LouisPauchet/open-permafrost-monitor/cao/AntennaSupport/AntennaSupport.3mf

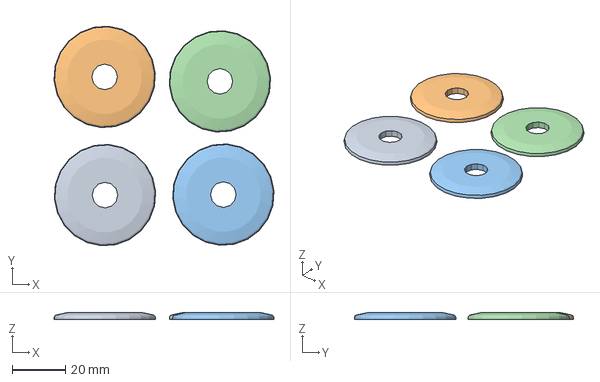
[picture p1: CAD file, 2026-07-15]
cao/AntennaSupport/AntennaSupport.3mf
82.3 x 82.1 x 2.60 mm
AntennaSupport.stl x 4
