LouisPauchet/open-permafrost-monitor/cao/RaspberryShake/GPSBoardMountA&B.3mf

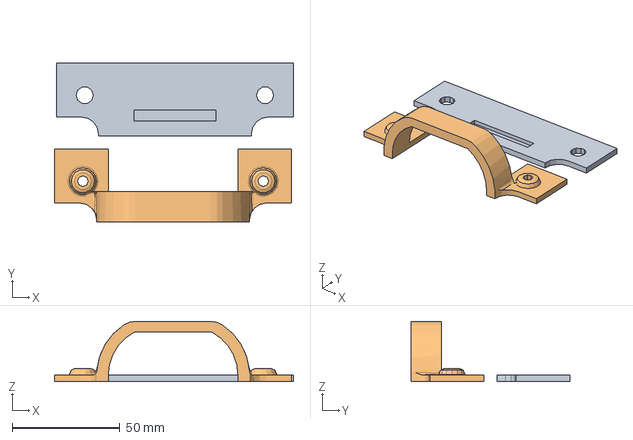
[picture p2: CAD file, 2026-08-08]
cao/RaspberryShake/GPSBoardMountA&B.3mf
111.0 x 73.7 x 28.0 mm
GPSBoardMountA.stl
GPSBoardMountB.stl
