LouisPauchet/open-permafrost-monitor/cao/AntennaSupport/AntennaSupport_v2.3mf

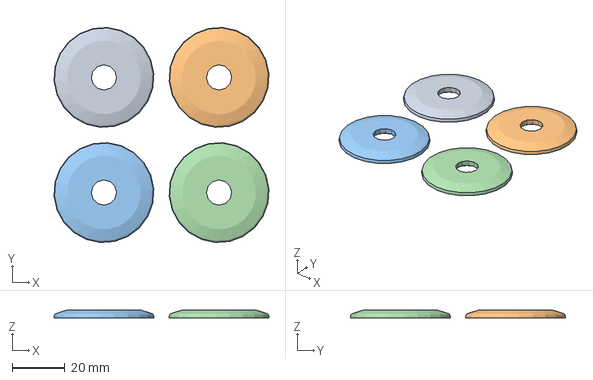
[picture p3: CAD file, 2026-07-15]
cao/AntennaSupport/AntennaSupport_v2.3mf
81.6 x 81.6 x 3.10 mm
AntennaSupport_v2.stl x 4
