LouisPauchet/open-permafrost-monitor/cao/RaspberryShake/GeophonesHolder.stl

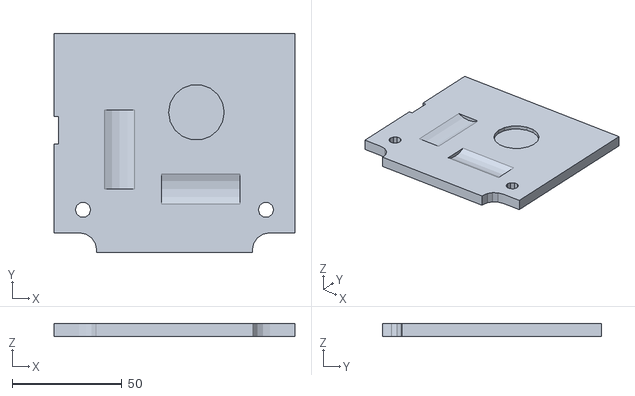
[picture p4: CAD file, 2026-08-08]
cao/RaspberryShake/GeophonesHolder.stl
110.0 x 100.0 x 6.00
