LouisPauchet/open-permafrost-monitor/cao/RaspberryShake/GPSBoardMountA.stl

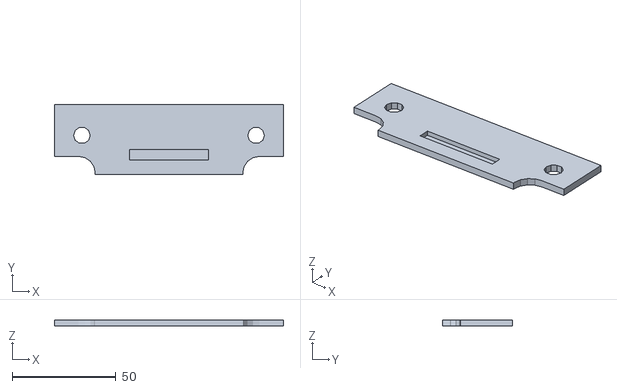
[picture p5: CAD file, 2026-08-08]
cao/RaspberryShake/GPSBoardMountA.stl
110.2 x 33.8 x 3.00
