LouisPauchet/open-permafrost-monitor/cao/RaspberryShake/GPSBoardMountB.stl

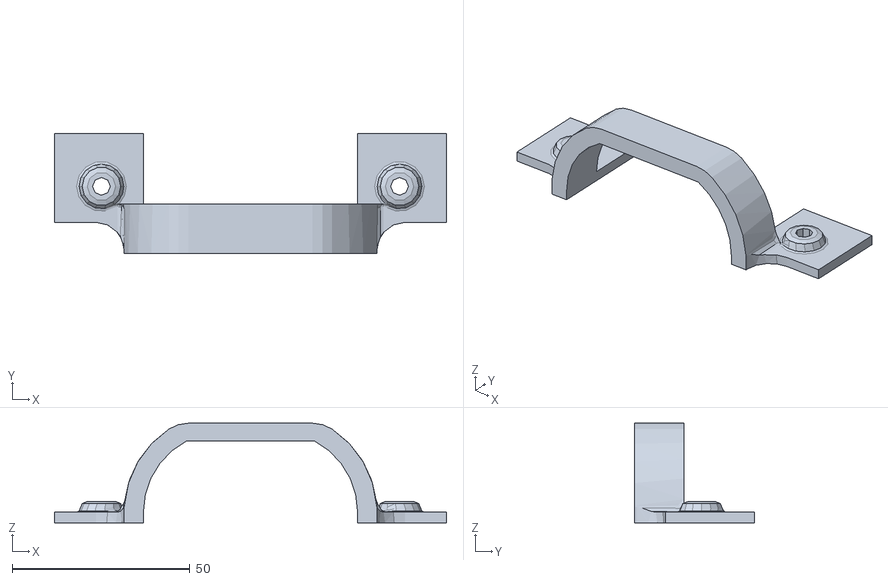
[picture p6: CAD file, 2026-08-08]
cao/RaspberryShake/GPSBoardMountB.stl
110.2 x 33.8 x 28.0
