LouisPauchet/open-permafrost-monitor/cao/RaspberryShake/GeophonesHolder_v3.4.3mf

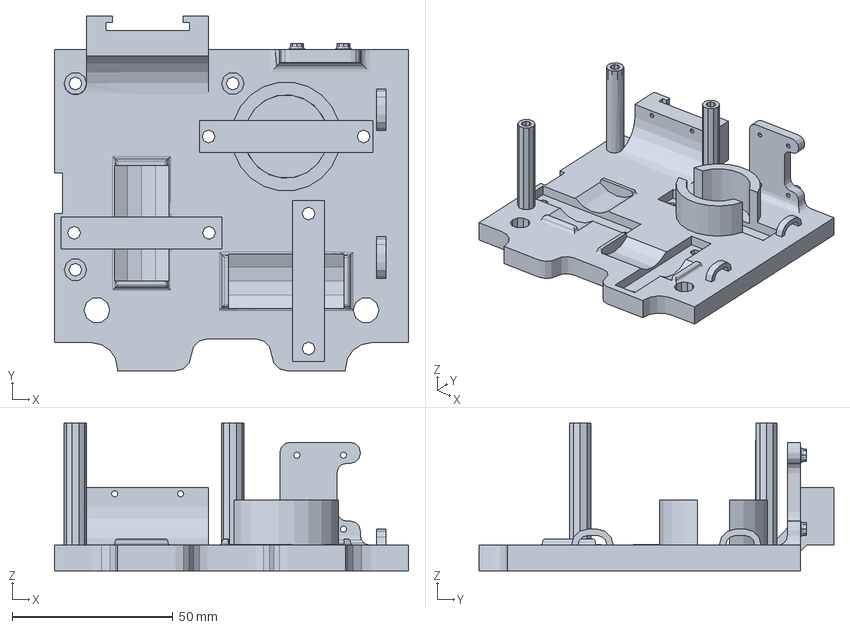
[picture p7: CAD file, 2026-08-08]
cao/RaspberryShake/GeophonesHolder_v3.4.3mf
110.2 x 110.5 x 46.0 mm
