LouisPauchet/open-permafrost-monitor/cao/RaspberryShake/GeophonesHolder_v3.3.3mf

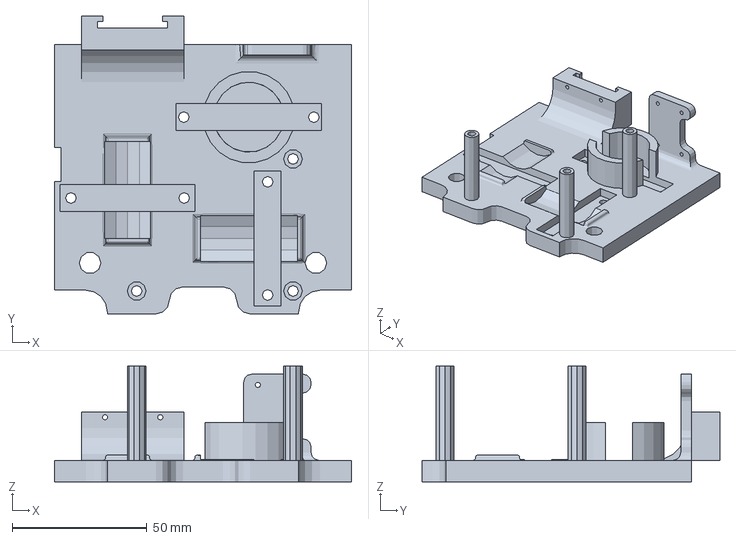
[picture p8: CAD file, 2026-08-08, an earlier design]
cao/RaspberryShake/GeophonesHolder_v3.3.3mf
110.2 x 110.5 x 43.0 mm
