LouisPauchet/open-permafrost-monitor/cao/RaspberryShake/GeophonesHolder_v3.1.3mf

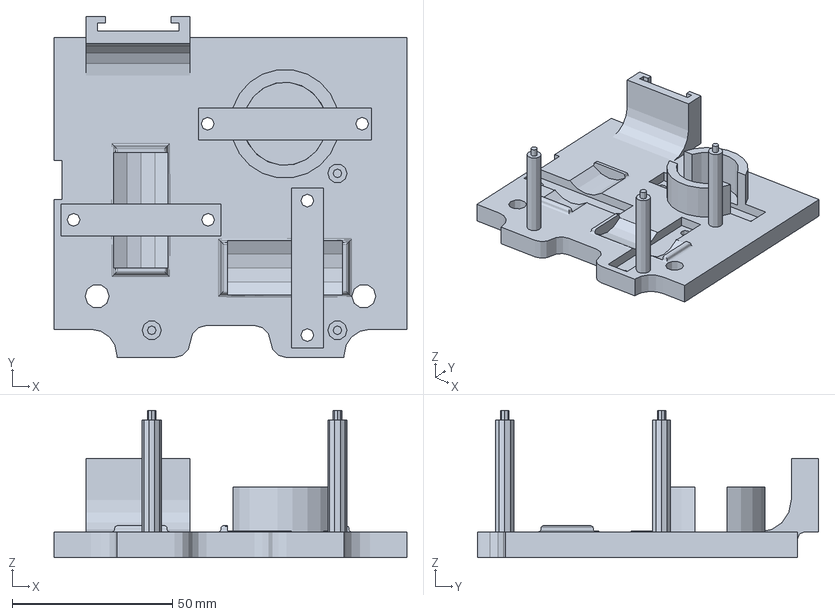
[picture p9: CAD file, 2026-08-08, an earlier design]
cao/RaspberryShake/GeophonesHolder_v3.1.3mf
110.2 x 106.5 x 46.0 mm
