LouisPauchet/open-permafrost-monitor/cao/RaspberryShake/GeophonesHolder_v3.3mf

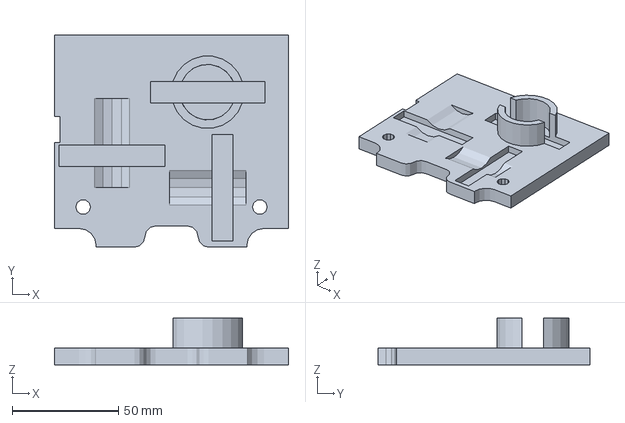
[picture p10: CAD file, 2026-08-08, an earlier design]
cao/RaspberryShake/GeophonesHolder_v3.3mf
110.2 x 100.0 x 22.0 mm
