LouisPauchet/open-permafrost-monitor/cao/RaspberryShake/GeophonesHolder_v2.3mf

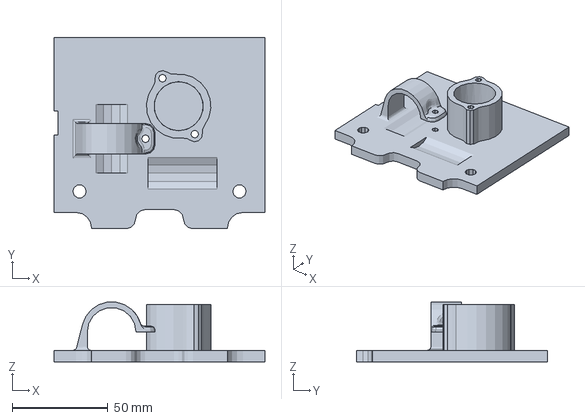
[picture p11: CAD file, 2026-08-08, an earlier design]
cao/RaspberryShake/GeophonesHolder_v2.3mf
110.2 x 100.0 x 31.2 mm
