LouisPauchet/open-permafrost-monitor/cao/RaspberryShake/GeophonesHolder_v3.2.3mf

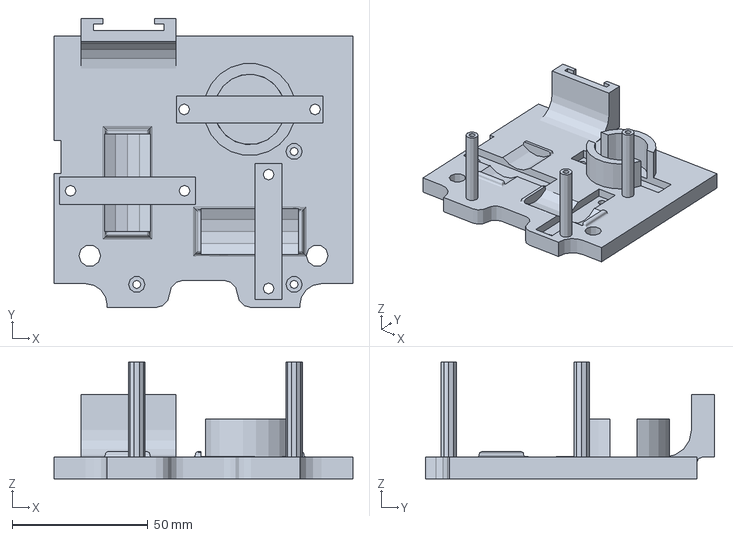
[picture p12: CAD file, 2026-08-08, an earlier design]
cao/RaspberryShake/GeophonesHolder_v3.2.3mf
110.2 x 106.5 x 43.0 mm
