LouisPauchet/open-permafrost-monitor/(list of files, cad)

Other CAD files:
cao/RaspberryShake/GeophonesHolder_v&.3mf
cao/RaspberryShake/GeophonesHolder_v1.3mf
cao/AntennaSupport/AntennaSupport.CATPart
cao/AntennaSupport/AntennaSupport.stl
cao/AntennaSupport/AntennaSupport_v2.stl
cao/RaspberryShake/Box_bottom.CATPart
cao/RaspberryShake/GPSBoardMountA.CATPart
cao/RaspberryShake/GPSBoardMountB.CATPart
cao/RaspberryShake/Geophones.CATPart
cao/RaspberryShake/GeophonesHolder.CATPart
cao/RaspberryShake/GeophonesHolder_v2.stl
cao/RaspberryShake/GeophonesHolder_v3.1.stl
cao/RaspberryShake/GeophonesHolder_v3.2.stl
cao/RaspberryShake/GeophonesHolder_v3.3.stl
cao/RaspberryShake/GeophonesHolder_v3.4.stl
cao/RaspberryShake/GeophonesHolder_v3.CATPart
cao/RaspberryShake/GeophonesHolder_v3.stl
cao/RaspberryShake/RaspberryShake.CATProduct
