LouisPauchet/open-permafrost-monitor/src/sd_storage.cpp

#include "sd_storage.h"
#include "pins.h"
#include <SD.h>
#include <SPI.h>
#include <USBMSC.h>
#include <freertos/FreeRTOS.h>
#include <freertos/semphr.h>
#include <freertos/task.h>
#include <string.h>

// Switched from native SDMMC to SD-over-SPI: repeated real-hardware failures
// (sdmmc_send_cmd 0x107 timeouts, ~14 in one overnight session even at the
// already-reduced 10MHz 1-bit SDMMC clock) on this board's "explicitly
// provisional" SD wiring (see the old clock-speed comment this replaced).
// SPI's timing/signal-integrity requirements are looser than native SD bus,
// which tends to tolerate marginal wiring better - at the cost of throughput,
// but this station's actual sustained write rate (400Hz geophone MiniSEED
// continuously, plus RTCM/UBX only during the ~2min/10min GNSS burst) is on
// the order of single-digit KB/s, nowhere near even a conservatively-clocked
// SPI link's ceiling. Same physical pins as before - an SD card's DAT3/CMD/
// CLK/DAT0 lines double as SPI's CS/MOSI/SCLK/MISO by design; only the host
// init sequence decides which protocol the card runs (see SD_D3_PIN's old
// comment about avoiding accidental SPI fallback in 1-bit SDMMC mode - D3 is
// now deliberately driven as CS instead).
static SPIClass sdSPI(HSPI);
static const uint32_t SD_SPI_CLOCK_HZ = 4000000; // 4MHz - conservative for
                                                   // signal-integrity margin,
                                                   // not throughput (see
                                                   // above); lower further if
                                                   // failures persist.

static bool available = false;
// Set by sdCheckEjectButton(), cleared once the card is actually detected
// physically removed (or on the next boot) - prevents sdCheckCardPresence()
// from immediately auto-remounting a card that's still sitting in the slot
// right after it was deliberately powered down for removal.
static bool ejected = false;

bool sdStorageInit() {
  pinMode(SD_POWER_EN_PIN, OUTPUT);
  digitalWrite(SD_POWER_EN_PIN, LOW); // active LOW enable; held on continuously -
                                       // geophone logging never stops, so unlike
                                       // the GNSS there's no per-cycle power gating.
  delay(50); // let the rail stabilize before the card sees clock/commands

  pinMode(SD_CARD_DETECT_PIN, INPUT); // sdCheckCardPresence() reads this every loop()
  pinMode(SD_EJECT_BUTTON_PIN, INPUT_PULLUP); // sdCheckEjectButton() reads this every loop()

  // begin(sck, miso, mosi, ss) - miso is the card's DAT0 line (card -> host),
  // mosi is CMD (host -> card), ss is DAT3 (chip select).
  sdSPI.begin(SD_CLK_PIN, SD_D0_PIN, SD_CMD_PIN, SD_D3_PIN);

  if (!SD.begin(SD_D3_PIN, sdSPI, SD_SPI_CLOCK_HZ, "/sdcard", 5, false /* format_if_empty */)) {
    Serial.println(F("SD: mount failed."));
    available = false;
    return false;
  }

  if (SD.cardType() == CARD_NONE) {
    Serial.println(F("SD: no card detected."));
    available = false;
    return false;
  }

  Serial.printf("SD: mounted, %llu MB\n", SD.cardSize() / (1024ULL * 1024ULL));
  available = true;

  // Fixed layout: /data for CSV-style logs, /data/gnss for one UBX file per
  // GNSS burst, /data/geophones for the continuous MiniSEED stream. mkdir()
  // only creates one level and isn't recursive, so /data has to exist
  // before its children; each call is idempotent (false on an
  // already-existing dir isn't an error, only matters on a fresh card).
  SD.mkdir("/data");
  SD.mkdir("/data/gnss");
  SD.mkdir("/data/geophones");

  return true;
}

bool sdStorageAvailable() {
  return available;
}

// Card-detect polarity confirmed on live hardware: HIGH while a card is
// seated, LOW once it's pulled. Mirrors checkFieldModeTrigger()'s
// debounce-then-restart shape in field_service.cpp - a clean reboot re-runs
// sdStorageInit() (and every other subsystem that only initializes once at
// boot) rather than trying to hand-roll an in-place re-mount that would
// also need every open-file/rotation-state owner (gnss.cpp,
// miniseed_writer.cpp, position_log.cpp) reset correctly too.
// restartAttempted caps this to one restart per detected insertion: if the
// card still won't mount after that (a real fault, not just a hot-plug
// timing thing), the station keeps running SD-less instead of
// reboot-looping forever.
void sdCheckCardPresence() {
  static unsigned long presentSinceMs = 0;
  static unsigned long absentSinceMs = 0;
  static bool restartAttempted = false;
  const unsigned long DEBOUNCE_MS = 200;

  bool present = digitalRead(SD_CARD_DETECT_PIN) == HIGH;

  if (present) {
    absentSinceMs = 0;
    if (!available && !restartAttempted && !ejected) {
      if (presentSinceMs == 0) {
        presentSinceMs = millis();
      } else if (millis() - presentSinceMs >= DEBOUNCE_MS) {
        restartAttempted = true;
        Serial.println(F("SD: card detected - rebooting to mount it cleanly."));
        sdStorageCloseAllForReboot();
        Serial.flush();
        delay(100);
        ESP.restart();
      }
    }
  } else {
    presentSinceMs = 0;
    if (available || ejected) {
      if (absentSinceMs == 0) {
        absentSinceMs = millis();
      } else if (millis() - absentSinceMs >= DEBOUNCE_MS) {
        Serial.println(F("SD: card removed - marking storage unavailable."));
        available = false;
        ejected = false;
        restartAttempted = false; // a freshly (re)inserted card gets its own attempt
      }
    }
  }
}

void sdCheckEjectButton() {
  static unsigned long lowSince = 0;
  static bool handledThisPress = false;
  const unsigned long DEBOUNCE_MS = 200;

  if (digitalRead(SD_EJECT_BUTTON_PIN) != LOW) {
    lowSince = 0;
    handledThisPress = false;
    return;
  }
  if (lowSince == 0) {
    lowSince = millis();
    return;
  }
  if (handledThisPress || millis() - lowSince < DEBOUNCE_MS) {
    return;
  }
  handledThisPress = true;

  if (available) {
    Serial.println(F("SD: eject button pressed - flushing and unmounting..."));
    sdStorageCloseAllForReboot();
    SD.end();
    digitalWrite(SD_POWER_EN_PIN, HIGH); // active LOW enable - HIGH cuts power
    available = false;
    ejected = true;
    Serial.println(F("SD: card unpowered - safe to remove now. Press the button again (or "
                      "just reinsert a card) to resume."));
  } else if (ejected) {
    Serial.println(F("SD: eject button pressed again - rebooting to remount."));
    Serial.flush();
    delay(100);
    ESP.restart();
  }
}

void sdBuildDailyPath(char *buf, size_t bufSize, const char *prefix,
                       const char *dateYYYYMMDD, const char *ext) {
  snprintf(buf, bufSize, "/%s_%s.%s", prefix, dateYYYYMMDD, ext);
}

File sdOpenForAppend(const char *path) {
  if (!available) {
    return File();
  }
  File f = SD.open(path, FILE_APPEND);
  if (!f) {
    Serial.printf("SD: failed to open %s for append.\n", path);
    // A card that failed to mount at all is caught by sdStorageInit()'s own
    // check, but one that mounted fine and then degraded mid-session (loose
    // connection, marginal signal integrity - see the clock-speed comment
    // in sdStorageInit()) previously kept getting retried every single
    // caller, every cycle, forever - each
    // retry against an already-wedged card is exactly the kind of unbounded
    // SD_MMC I/O that's landed a task-watchdog abort on live hardware
    // (confirmed: the boot immediately after one such abort failed to mount
    // at all, "sdmmc_host_wait_for_event returned 0x107"). Latching false
    // here after the first real failure stops hammering a card that's
    // already in a bad state - the tradeoff is losing the rest of this boot's
    // logging if it was a one-off glitch rather than genuine degradation,
    // preferable to repeatedly risking another stall.
    available = false;
  }
  return f;
}

// --- Async stream writer (see sd_storage.h for why) ---

namespace {

struct StreamRing {
  uint8_t buf[4096]; // comfortably covers a worst-case ~2200-byte UBX RAWX
                      // frame plus margin; RTCM only ever needs a fraction
                      // of this between 50ms drains, sized the same for
                      // simplicity, not because it needs to be this big.
  size_t len = 0;
  SemaphoreHandle_t mutex = nullptr;
};

struct StreamState {
  File file;
  char pendingPath[64] = "";
  char pendingHeader[128] = ""; // empty = no header requested for this open
  volatile bool openPending = false;
  volatile bool closePending = false;
  volatile bool flushPending = false;
};

StreamRing g_ring[SD_STREAM_COUNT];
StreamState g_stream[SD_STREAM_COUNT];
TaskHandle_t g_writerTask = nullptr;

// Runs on its own task - every blocking SD_MMC call (open/write/flush/
// close) happens here and only here, so a wedged card blocks this task,
// not whichever one called sdStreamWrite()/Open()/Close().
void sdWriterTaskFn(void *) {
  const TickType_t drainPeriod = pdMS_TO_TICKS(50);
  unsigned long lastFlushMs = 0;
  uint8_t local[sizeof(StreamRing::buf)]; // task-owned scratch, not on the stack per-iteration

  for (;;) {
    for (int s = 0; s < SD_STREAM_COUNT; s++) {
      StreamState &st = g_stream[s];

      if (st.openPending) {
        st.openPending = false;
        if (st.file) {
          st.file.close();
        }
        st.file = sdOpenForAppend(st.pendingPath);
        Serial.printf("SD writer: stream %d open %s -> %s\n", s, st.pendingPath,
                      st.file ? "ok" : "FAILED");
        if (st.file && st.pendingHeader[0] != '\0' && st.file.size() == 0) {
          st.file.printf("%s\n", st.pendingHeader);
        }
      }

      StreamRing &ring = g_ring[s];
      xSemaphoreTake(ring.mutex, portMAX_DELAY);
      size_t n = ring.len;
      if (n > 0) {
        memcpy(local, ring.buf, n);
        ring.len = 0;
      }
      xSemaphoreGive(ring.mutex);

      if (n > 0 && st.file && available) {
        size_t written = st.file.write(local, n);
        if (written != n) {
          // Same failure class (and the same 0x107 SD_MMC error code) that
          // motivated sdOpenForAppend()'s latch below - a card that starts
          // failing writes mid-session is almost never a one-write glitch,
          // and blindly retrying every 50ms drain cycle against an
          // already-wedged card is exactly the unbounded SD_MMC I/O that's
          // previously landed a task-watchdog abort on live hardware. This
          // was previously unchecked entirely - a partial/failed write here
          // was silently dropped (data loss with no log line and no
          // backoff), not just "logged but fine". Latching `available`
          // false stops every stream, matching the open-path's tradeoff:
          // lose the rest of this boot's logging rather than keep risking
          // another stall.
          Serial.printf("SD writer: stream %d write failed (%u/%u bytes) - marking "
                         "storage unavailable.\n",
                         s, (unsigned)written, (unsigned)n);
          available = false;
        }
      }

      if (st.flushPending) {
        st.flushPending = false;
        if (st.file) {
          st.file.flush();
        }
      }

      if (st.closePending) {
        st.closePending = false;
        if (st.file) {
          st.file.close();
        }
      }
    }

    // Periodic flush (not per-stream-close, which already flushes via
    // close()) so a crash mid-burst loses at most this interval's worth of
    // data rather than everything since the file was opened - same reason
    // main.cpp already does this for MiniSEED, just relocated off the loop
    // task along with everything else here. 2s (was 5s) after real-world
    // testing showed repeated abrupt resets (dev-time reflashing, but also
    // genuine SD card hiccups) losing/corrupting more than expected -
    // shrinks the exposure window for the continuous high-rate UBX/RTCM/
    // MiniSEED streams (positions CSV already flushes every row, see
    // position_log.cpp).
    if (millis() - lastFlushMs >= 2000) {
      lastFlushMs = millis();
      for (int s = 0; s < SD_STREAM_COUNT; s++) {
        if (g_stream[s].file) {
          g_stream[s].file.flush();
        }
      }
    }

    vTaskDelay(drainPeriod);
  }
}

} // namespace

void sdWriterInit() {
  for (int s = 0; s < SD_STREAM_COUNT; s++) {
    g_ring[s].mutex = xSemaphoreCreateMutex();
  }
  // Core 0, deliberately: loopTask and WalterModem's own queueProcessing/
  // eventProcessing tasks are all already on core 1 (see modem.cpp) - no
  // reason to add a fourth task competing there when core 0 is otherwise
  // idle. Stack sized for the 4KB scratch buffer above plus SD_MMC/FatFs's
  // own internal call depth with real margin.
  xTaskCreatePinnedToCore(sdWriterTaskFn, "sdWriterTask", 10240, NULL, 1, &g_writerTask, 0);
}

void sdStreamOpen(SdStream stream, const char *path, const char *headerIfEmpty) {
  StreamState &st = g_stream[stream];
  strncpy(st.pendingPath, path, sizeof(st.pendingPath) - 1);
  st.pendingPath[sizeof(st.pendingPath) - 1] = '\0';
  if (headerIfEmpty) {
    strncpy(st.pendingHeader, headerIfEmpty, sizeof(st.pendingHeader) - 1);
    st.pendingHeader[sizeof(st.pendingHeader) - 1] = '\0';
  } else {
    st.pendingHeader[0] = '\0';
  }
  st.openPending = true;
}

bool sdStreamIsOpen(SdStream stream) {
  return g_stream[stream].file && !g_stream[stream].openPending;
}

void sdStreamWrite(SdStream stream, const uint8_t *data, size_t len) {
  StreamRing &ring = g_ring[stream];
  xSemaphoreTake(ring.mutex, portMAX_DELAY); // just a bounded memcpy - never blocks on SD I/O
  size_t space = sizeof(ring.buf) - ring.len;
  size_t n = len < space ? len : space; // drop the tail if the writer task can't keep up
  if (n > 0) {
    memcpy(ring.buf + ring.len, data, n);
    ring.len += n;
  }
  xSemaphoreGive(ring.mutex);
}

void sdStreamFlush(SdStream stream) {
  g_stream[stream].flushPending = true;
}

void sdStreamClose(SdStream stream) {
  g_stream[stream].closePending = true;
}

bool sdStorageCloseAllForReboot(unsigned long timeoutMs) {
  for (int s = 0; s < SD_STREAM_COUNT; s++) {
    sdStreamClose((SdStream)s);
  }
  unsigned long start = millis();
  for (;;) {
    bool allDone = true;
    for (int s = 0; s < SD_STREAM_COUNT; s++) {
      if (g_stream[s].closePending) {
        allDone = false;
        break;
      }
    }
    if (allDone) {
      return true;
    }
    if (millis() - start >= timeoutMs) {
      // A wedged card (see the writer task's write-failure latch above)
      // means the writer task itself could be stuck, or `available` may
      // have already gone false, in which case closePending is consumed
      // without any of the actual SD_MMC work - this timeout is only a
      // safety net for a genuinely stuck case, not the normal path.
      Serial.println(F("SD: close-all-for-reboot timed out - proceeding anyway."));
      return false;
    }
    delay(20);
  }
}

// --- USB mass storage (field service mode only, see sd_storage.h) ---

namespace {

USBMSC usbMsc; // global on purpose - its constructor registers the MSC
                // interface with TinyUSB's descriptor builder, which must
                // happen before USB.begin() finalizes the composite
                // descriptor; a global's constructor runs early enough
                // (static init, before app_main/setup) to guarantee that
                // regardless of where in setup() sdStorageMscBegin() runs.

int32_t mscRead(uint32_t lba, uint32_t offset, void *buffer, uint32_t bufsize) {
  if (!available) {
    return -1;
  }
  uint8_t sector[512];
  if (!SD.readRAW(sector, lba)) {
    return -1;
  }
  uint32_t n = bufsize;
  if (offset + n > sizeof(sector)) {
    n = sizeof(sector) - offset; // clamp - shouldn't happen at native 512B blocks
  }
  memcpy(buffer, sector + offset, n);
  return (int32_t)n;
}

int32_t mscWrite(uint32_t lba, uint32_t offset, uint8_t *buffer, uint32_t bufsize) {
  if (!available) {
    return -1;
  }
  uint8_t sector[512];
  // TinyUSB's MSC driver normally requests whole 512B blocks (offset=0,
  // bufsize=512) - the read-modify-write below only matters for the rare
  // partial-sector case, so a genuine full-block write skips the extra
  // read.
  if (offset != 0 || bufsize != sizeof(sector)) {
    if (!SD.readRAW(sector, lba)) {
      return -1;
    }
  }
  uint32_t n = bufsize;
  if (offset + n > sizeof(sector)) {
    n = sizeof(sector) - offset;
  }
  memcpy(sector + offset, buffer, n);
  if (!SD.writeRAW(sector, lba)) {
    return -1;
  }
  return (int32_t)n;
}

bool mscStartStop(uint8_t /*power_condition*/, bool /*start*/, bool /*load_eject*/) {
  return true;
}

} // namespace

void sdStorageMscBegin() {
  if (!available) {
    return; // card never mounted - leave the LUN at its all-zero defaults
  }
  usbMsc.vendorID("WALTER");
  usbMsc.productID("SD CARD");
  usbMsc.productRevision("1.0");
  usbMsc.onRead(mscRead);
  usbMsc.onWrite(mscWrite);
  usbMsc.onStartStop(mscStartStop);
  usbMsc.begin((uint32_t)SD.numSectors(), (uint16_t)SD.sectorSize());
}

void sdStorageMscEnable() {
  if (!available) {
    return;
  }
  sdStorageCloseAllForReboot();
  usbMsc.mediaPresent(true);
}
