LouisPauchet/open-permafrost-monitor/include/sd_storage.h

#pragma once
#include <Arduino.h>
#include <FS.h>

// SD-over-SPI storage (see sd_storage.cpp for why - migrated off native
// SDMMC), mounted once at boot and held powered continuously, since the
// geophone writes to it 24/7. Fixed
// layout: /data for CSV-style logs, /data/gnss for per-burst GNSS UBX/RTCM
// captures, /data/geophones for the continuous MiniSEED stream (see
// sdStorageInit()). Shared "daily file" path primitive used by every
// single-file-per-day writer (MiniSEED, position CSV) - the per-burst GNSS
// files use their own naming, see gnss.cpp.

bool sdStorageInit();
bool sdStorageAvailable();

// Polls SD_CARD_DETECT_PIN (debounced) - reboots to cleanly mount a newly
// (re)inserted card, or marks storage unavailable the moment one is pulled
// rather than waiting for the next write to fail. Call every loop().
void sdCheckCardPresence();

// Polls SD_EJECT_BUTTON_PIN (debounced, see pins.h) - on a press, flushes
// and closes every stream, unmounts SD_MMC, and cuts power to the card's
// rail so it's genuinely safe to pull, not just "files are closed" (an SD
// card's bus lines can still be mid-transaction electrically even with
// every file handle closed). No separate "resume" step: re-inserting a
// card is picked up by sdCheckCardPresence()'s existing remount path. Call
// every loop().
void sdCheckEjectButton();

// Builds "/<prefix>_<dateYYYYMMDD>.<ext>" into buf.
void sdBuildDailyPath(char *buf, size_t bufSize, const char *prefix,
                       const char *dateYYYYMMDD, const char *ext);

// Opens (creating if needed) a file for appending. Returned File's
// operator bool() is false if SD isn't available or the open failed.
File sdOpenForAppend(const char *path);

// --- Async stream writer ---
//
// Arduino's SD_MMC File API has no non-blocking mode of its own. Live
// hardware hit a task-watchdog abort with the exact same *shape* as the
// modem crashes fixed earlier (a blocking call landing on loopTask, no
// timeout, past the watchdog) but from SD_MMC.write() instead: a burst of
// "sdmmc_send_cmd returned 0x107" (ESP_ERR_TIMEOUT) errors under heavy
// GNSS burst write traffic, then total silence for ~60s before the abort -
// a degrading/wedged card, not the earlier RTCM-clock-speed issue (that
// one made mount/write fail fast and visibly; this one just stopped
// returning).
//
// A fixed, small set of named streams (not a general multi-file system -
// just enough for this firmware's actually-continuous writers) backed by a
// dedicated task: the caller only ever does a fast, bounded memcpy into a
// ring buffer (silently dropping data if the writer task can't keep up -
// same tradeoff already accepted for the modem's own socketRxBuf), so a
// wedged card can only ever block the writer task, never loopTask.
enum SdStream : uint8_t {
  SD_STREAM_UBX = 0,
  SD_STREAM_RTCM = 1,
  SD_STREAM_MINISEED = 2,
  SD_STREAM_POSITIONS = 3,
  SD_STREAM_COUNT,
};

// Starts the writer task - call once from setup(), after sdStorageInit().
void sdWriterInit();

// Closes any file currently open for this stream, then opens path (created
// if needed) for the NEXT write - both happen on the writer task, not here.
// headerIfEmpty, if non-NULL, is written (with a trailing newline) right
// after opening, but only if the file turned out to be empty - lets a
// caller like position_log.cpp ensure a header row without its own
// blocking SD_MMC.exists() check: opening the same still-populated file
// again after a same-day reboot (currentDate resets, but the file and its
// header don't) just skips it.
void sdStreamOpen(SdStream stream, const char *path, const char *headerIfEmpty = nullptr);

// True once the writer task has actually opened this stream's file - lets a
// caller like position_log.cpp's day-rollover rotation notice a failed open
// (e.g. a transient SD hiccup at the exact moment of rotation, confirmed on
// live hardware: a positions.csv rotation raced the tail end of a GNSS
// burst's SD writes) and retry, instead of silently disabling that stream
// until the next reboot.
bool sdStreamIsOpen(SdStream stream);

// Appends data to the stream's ring buffer. Fast and non-blocking - the
// actual SD write happens later, on the writer task.
void sdStreamWrite(SdStream stream, const uint8_t *data, size_t len);

// Requests that the writer task flush this stream's file as soon as it next
// drains the ring buffer (still off-caller's-task, still non-blocking here)
// instead of waiting for the periodic 5s sweep. FatFs updates the on-disk
// directory entry (size, cluster chain) as part of f_sync/flush, so this
// bounds how much of a stream can be lost or leave the filesystem
// inconsistent if power is cut before the next periodic flush - worth the
// extra SD_MMC round trip for a low-volume, high-value stream like the
// position/displacement CSV (one row per measurement cycle), not worth it
// for the continuous high-rate UBX/RTCM/MiniSEED streams which already get
// the periodic sweep.
void sdStreamFlush(SdStream stream);

// Closes the stream's current file (flushing it in the process) once the
// writer task has drained whatever's still in the ring buffer.
void sdStreamClose(SdStream stream);

// Closes every stream and blocks (bounded by timeoutMs) until the writer
// task confirms all of them are done - call this right before any
// self-triggered ESP.restart() (see field_service.cpp, sd_storage.cpp's own
// card-detect remount) so nothing is left open across the reset. A reset
// the firmware itself decided to take is exactly the corruption risk this
// exists to close off - see sdOpenForAppend()'s and the writer task's write
// path's own comments for what's at stake (FAT metadata mid-update, not
// just the newest unflushed bytes). Returns false (without hanging forever)
// if the writer task doesn't confirm in time - the caller should still
// proceed with its restart either way, this is a best-effort reduction of
// the exposure window, not a guarantee.
bool sdStorageCloseAllForReboot(unsigned long timeoutMs = 1000);

// --- USB mass storage (field service mode only) ---
//
// Exposes the SD card as a USB drive on the same port as the console
// (composite CDC+MSC, see platformio.ini's ARDUINO_USB_MODE=0), so a
// technician can drag files off the card directly instead of the old
// slow serial download. The MSC LUN is always present in the USB
// descriptor once sdStorageMscBegin() runs (removing/adding USB
// interfaces after enumeration isn't possible), but reports "no media"
// until sdStorageMscEnable() is called - normal operation never calls
// it, so the drive stays inert (and FatFs keeps sole ownership of the
// card) outside field service mode.

// Call once from setup(), after sdStorageInit() (needs the card's real
// sector count/size) and before USB.begin().
void sdStorageMscBegin();

// Call when entering field service mode: closes every open FatFs stream
// (a host doing raw sector I/O and firmware doing buffered FatFs I/O on
// the same card at once would corrupt it) and marks the drive present.
void sdStorageMscEnable();
