LouisPauchet/open-permafrost-monitor/(commit log)

2026-07-15 Update restard logic
    [AntennaSupport.3mf, AntennaSupport.CATPart, AntennaSupport.stl, AntennaSupport_v2.3mf, AntennaSupport_v2.stl]
2026-08-08 Guard against blank/corrupt device config being saved or loaded
    A phone auto-probing the setup portal's captive-portal-detection page
    could trigger a save with empty form fields, silently wiping a working
    MQTT/NTRIP config with blanks. Validate on both save (reject obviously
    blank submissions) and load (fall back to compiled-in defaults if NVS
    already holds a blank/corrupt entry from before this fix existed).
    [device_config.cpp]
2026-08-08 Add Raspberry Shake RS3D geophone protocol documentation and CAD files
    Reverse-engineered digitizer-to-host UART protocol (JSON sample stream,
    230400 baud), timing/GPS notes, and enclosure CAD, gathered ahead of
    integrating the geophone into the field station firmware.
    [Box_bottom.CATPart, GPSBoardMountA&B.3mf, GPSBoardMountA.CATPart, GPSBoardMountA.stl, GPSBoardMountB.CATPart, GPSBoardMountB.stl, Geophones.CATPart, GeophonesHolder.CATPart]
2026-08-08 Move to Walter ESP32-S3 + cellular modem, drop WiFi entirely
    Stage 1 of the field-deployment rewrite: swap the WiFi-tethered ESP32
    DevKit V1 bring-up rig for the Walter ESP32-S3 board (Sequans GM02SP
    LTE-M/NB-IoT modem), per the new pinout for the field carrier board.
    - New include/modem.h + src/modem.cpp: thin wrapper around the
    quickspot/WalterModem library exposing a raw TCP socket (NTRIP), MQTT
    client (telemetry), and HTTP client (daily upload) behind simple
    blocking-style calls, so the rest of the firmware doesn't touch the
    modem's async AT-command event model directly.
    - ntrip_client.cpp and mqtt_client.cpp: transport swapped from
    WiFiClient/WiFiClientSecure+PubSubClient to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
    [main.cpp, modem.cpp, modem.h, mqtt_client.cpp, ntrip_client.cpp, pins.h, spi_flash_mmap.h]
2026-08-09 Enable native USB CDC console and AT command debug logging
    ARDUINO_USB_MODE/ARDUINO_USB_CDC_ON_BOOT are needed for the Walter
    ESP32-S3's native USB Serial console (used throughout - modem debug
    output, and later the field-service menu). CORE_DEBUG_LEVEL=4 surfaces
    WalterModem's own ESP_LOGD AT command TX/RX trace, which is otherwise
    invisible at Arduino's default log level and was essential for
    diagnosing modem bring-up issues live on hardware.
2026-08-09 Replace SPI sd_logger scaffold with SD_MMC-based sd_storage
    The old sd_logger.h/.cpp was a placeholder SPI/SD.h reader written
    before real hardware was available. The Walter carrier board wires the
    SD card to the native SDMMC peripheral in 1-bit mode instead, so this
    replaces it with sd_storage: mount-once at boot (power rail enabled via
    SD_POWER_EN_PIN, held on continuously since geophone logging never
    stops), plus shared open-or-rotate-by-date helpers used by every daily
    file writer (GNSS raw log, MiniSEED, position CSV).
    [sd_storage.cpp, sd_storage.h]
2026-08-09 Add GNSS date/time accessors and daily-rotated raw log
    Exposes gnssYear/Month/Day/Hour/Minute/Second/Millisecond() (needed by
    miniseed_writer for GPS-sourced sample timestamps, since the geophone
    digitizer has no clock of its own) and gnssDateString() for daily
    filenames, and rotates a raw NMEA/UBX capture file on sd_storage for
    PPK/PPP post-processing.
    Also splits initGNSS() into a one-time UART bring-up (guarded, since
    HardwareSerial::setRxBufferSize() errors if called on an
    already-running UART) and gnssReenableMessages() (resends the
    GST/RAWX/SFRBX enable commands, safe to repeat every wake cycle) - the
    persistent main loop now calls initGNSS() every fix cycle, not just
    once at boot.
    [gnss.cpp, gnss.h]
2026-08-09 Add Raspberry Shake RS3D geophone reader and minimal MiniSEED writer
    geophone.cpp reads the RS3D digitizer's continuous 230400 baud,
    newline-free JSON stream (protocol reverse-engineered in
    raspberry_shake.md) via brace-depth object boundary detection, and
    extracts channel + hex-encoded int32 samples per raspberry_shake.md's
    sign-handling warning. Exposes geophoneAwareDelay(), a delay() helper
    that keeps polling internally, used wherever other modules currently
    block (modem/NTRIP) so the continuous UART stream never overruns its
    buffer during network operations.
    miniseed_writer.cpp is a small from-scratch writer (not libmseed) using
    uncompressed 32-bit int encoding rather than Steim1/2 - 4x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
2026-08-09 Add daily position CSV log and battery voltage reads
    position_log.cpp appends one row per GNSS fix cycle to a daily-rotated
    CSV on sd_storage; it doubles as the MQTT batch buffer (see the
    upcoming batching commit) - no separate in-RAM structure, unsent rows
    are just read back off the file.
    battery.cpp reads BATTERY_EXTERNAL_ADC_PIN/BATTERY_INTERNAL_ADC_PIN via
    analogReadMilliVolts() and converts to volts. Divider ratios are
    placeholders pending calibration against real hardware.
    [battery.cpp, position_log.cpp, position_log.h]
2026-08-09 Extend device config with daily-upload endpoint fields
    Adds upload_host/upload_port/upload_api_key to the persisted
    DeviceConfig struct (seeded from secrets.h defaults, overridable via
    the field-service menu, same NVS load/save + blank-config guard as the
    existing fields) for the daily file upload client.
2026-08-09 Add field-service config menu and SD file download over USB CDC
    Replaces config_portal (WiFiManager) with a text menu over native USB
    serial for device configuration (measurement interval, fix timeout,
    accuracy threshold, MQTT, NTRIP, upload endpoint) plus SD card file
    listing/download - both reachable together over one service cable,
    since a technician needs both in the same field visit.
    True USB mass-storage passthrough was considered but dropped: the
    installed SD_MMC library keeps its sdmmc_card_t handle protected, with
    no public API to bridge it to USBMSC's sector read/write callbacks.
    File download over the same CDC connection avoids that entirely, and
    avoids two things (firmware's FAT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
    [field_service.cpp, field_service.h]
2026-08-09 Batch MQTT telemetry publishes instead of one per GNSS fix
    mqttPublishPosition() (single reading, connect/publish/disconnect
    every fix) is replaced by mqttPublishBatch(), which publishes every
    unsent position_log row (see previous position_log commit) accumulated
    since the last batch as one JSON array message. Lets the modem's MQTT
    session stay infrequent - connect once per telemetry-batch interval
    rather than once per GNSS fix - so it spends more time asleep.
    [mqtt_client.cpp, mqtt_client.h]
2026-08-09 Add chunked API-key HTTP upload client for daily file push
    One plain authenticated HTTP POST per file to a backend the user runs
    themselves (Basic auth, API key as username) rather than on-device AWS
    SigV4 signing - the backend holds the real S3-compatible credentials
    and forwards the file, so the field-deployed device only ever carries
    one rotatable API key. Files larger than WalterModem's httpSend cap
    (uint16_t, 65535 bytes) are split into 32KB chunks, each POSTed as
    ?part=<n>&total=<N>&final=<0|1>.
2026-08-09 Rewrite main loop as persistent scheduler for continuous geophone capture
    Continuous 24/7 geophone capture (confirmed requirement) can't tolerate
    esp_deep_sleep_start(): deep sleep halts the CPU and UART peripherals,
    and the digitizer streams continuously with no way to pause it. loop()
    now runs forever, polling the geophone and GNSS UART every single
    iteration (highest priority, must never be starved), with everything
    else scheduled off its own millis() timer instead of one
    wake/measure/sleep cycle per boot:
    - GNSS fix cycle on measurement_interval_s, unchanged wait-for-good-fix
    logic, now also wakes/connects NTRIP and appends to position_log.
    - Telemetry batch on a fixed 1-hour timer (d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
    [main.cpp]
2026-08-09 Fix modem PDP context, socket receive, and a socket callback stack overflow
    Three issues found bringing the modem up on real hardware:
    - definePDPContext() failed unconditionally: AT+CGDCONT? showed context
    1 already provisioned as type "IP" in the modem's own NVM (carried
    over from prior board testing), and this firmware rejects touching an
    already-defined context at all - confirmed by re-sending the exact
    same value and still getting +CME ERROR: 4. Query-and-log instead of
    requiring the (impossible) redefinition to succeed.
    - socketEventHandler() sized its AT+SQNSRECV request off the RING
    event's data_len, which this firmware's +SQNSRING URC never actually
    carries (always 0)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
    [modem.cpp]
2026-08-09 Add GNSS raw-UART smoke test to isolate wiring/baud from sleep/wake bugs
    Live hardware test showed zero GNSS bytes received over an entire 120s
    fix-wait window (gnssCharsProcessed() < 10) despite the F9P's own LED
    showing a fix - i.e. the raw UART link, not just fix quality. But
    setup() already puts the module through one gnssSleep()/gnssWakeup()
    cycle before loop() ever starts polling+printing, so that symptom is
    ambiguous between "the raw link never worked" and "the sleep/wake
    cycle broke it". This adds a 3s raw-listen window right after the
    first initGNSS(), before the first gnssSleep(), to get a definitive
    byte count independent of the sleep/wake path.
    [main.cpp]
2026-08-09 Move socket receive off the event-handler task to fix a modem crash
    Live hardware crashed with LoadProhibited inside WalterModem's own
    _finishModemCMD (WalterModem.cpp:1685), right after a stray "+CME
    ERROR: 4" arrived with no matching outstanding command. Root cause:
    socketEventHandler() called modem.socketReceive() - a blocking AT
    command - directly from the RING event, which the library dispatches
    on its own _eventProcessingTask. That's a different task than the main
    Arduino loop, which also issues its own blocking AT commands (e.g. GGA
    sends) concurrently. The library's single-outstanding-command pipeline
    (_cmdProcessingTask/_curCmd) isn't safe against two tasks submitting
    blocking comma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
    [modem.cpp]
2026-08-09 Drain the socket ring in modemSocketRead() too, not just Available()
    Follow-up to the previous cross-task race fix: that change moved the
    actual AT+SQNSRECV call into drainSocketRing(), invoked only from
    modemSocketAvailable(). ntripPoll() - the function that actually
    forwards RTCM to the F9P - calls modemSocketRead() directly and never
    calls Available() first, so the drain point was never reached during
    normal streaming. Live hardware confirmed it: 13 RING events arrived
    with no AT+SQNSRECV ever sent, the modem's own socket buffer went
    unread for 100+ seconds, and the caster/modem eventually hung up the
    socket (+SQNSH) - the GNSS fix stayed autonomous (2m) since no RTCM
    ever reached the F9P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
    [modem.cpp]
2026-08-09 Shrink and pace socket receive requests to reduce modem desync risk
    Live hardware hit a run where a sustained RTCM burst produced several
    unsolicited "+CME ERROR: 4" responses with no matching AT+SQNSRECV
    request from us - a response-tracking desync between the app and the
    modem/library, distinct from (and not fixed by) the earlier cross-task
    race fix. WalterModem 1.5.0 is already the latest release and already
    contains the fix for a related upstream bug (QuickSpot/walter-arduino
    #109, socket-close-before-SQNSRECV race), so this isn't that.
    Not a proven root-cause fix - reduces how hard the AT channel gets
    hammered during a burst: smaller per-request chunk (1500 -> 512 bytes,
    shorter round-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
    [modem.cpp]
2026-08-09 Add a task watchdog as a self-recovery safety net
    Live hardware produced a run where the modem's AT command channel
    appeared to lock up mid-NTRIP-stream (see previous commit) - whether
    that's a true permanent deadlock or just WalterModem's own 180s
    internal command timeout not having been waited out is hard to say for
    certain from a serial log alone, and either way a field-deployed,
    unattended station can't rely on someone noticing and power-cycling it.
    Adds the ESP32 task watchdog (210s - above WalterModem's own 180s
    AT command timeout, so a command that the library itself fails to
    unstick still gets a chance to resolve before we intervene) watching
    the main loop task, with panic=true so a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
    [geophone.cpp, geophone.h, main.cpp, upload_client.cpp]
2026-08-09 Fix real root cause of the socket-receive crash: uart_event_task stack
    Live hardware crashed again with "Stack canary watchpoint triggered
    (uart_event_task)" right after AT+SQNSRECV=1,512, despite the earlier
    fix that moved our own socketEventHandler() off the stack. Traced this
    one further down: WalterModem registers its RX handler on the modem's
    Serial2 via HardwareSerial::onReceive() (WalterModem.cpp, _uart->
    onReceive(_handleRxData)), and arduino-esp32 core runs every
    onReceive() callback on a task it spawns itself - literally named
    "uart_event_task" (HardwareSerial.cpp _uartEventTask) - with a
    hardcoded 2048-byte default stack (ARDUINO_SERIAL_EVENT_TASK_STACK_SIZE
    in HardwareSerial.cpp)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
2026-08-09 Reverse socket-drain pacing: drain bursts fast, not slow
    Live hardware exposed the actual mechanism behind the AT desync
    symptoms chased over the last few commits: WalterModem keeps a fixed
    8-buffer pool (WalterModem.h, WALTER_MODEM_BUFFER_POOL_SIZE) and every
    queued incoming line - including plain URCs like +SQNSRING, not just
    command responses - holds one slot until _cmdProcessingTask processes
    it. After a ~10s network lull, seven +SQNSRING notifications arrived
    within milliseconds of each other; the previous commit's 512-byte
    chunk size and 50ms pacing gap between drains meant we could only
    retire one slot every ~50ms+round-trip, and the backlog blew past 8
    ("No free buffers", logged live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
    [modem.cpp]
2026-08-09 Shorten watchdog timeout: 210s -> 60s, confirmed no library self-recovery
    Live hardware proved out the assumption behind the original 210s value
    wrong. That number was set above WalterModem's own 180s internal AT
    command timeout so our watchdog would only act as a last-resort backstop
    if the library's own timeout failed to recover a wedged command. But a
    stuck socketReceive() produced zero "Command time-out" warnings (what
    the library logs when WALTER_MODEM_CMD_TIMEOUT_MS fires) across the
    entire 215s until our watchdog reset the device - the stuck command
    never became _curCmd for the library's own timeout logic to notice, so
    there was never a library-side recovery to wait for in the first p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
    [main.cpp]
2026-08-09 Make socket receive async: a lost AT command must not cost the fix cycle
    User feedback: letting a stuck command freeze the device and recover via
    watchdog reboot is not acceptable during a fix cycle - that's exactly
    when NTRIP corrections are needed, and a reboot throws the whole
    in-progress session away. Confirmed on live hardware that this isn't
    rare: WalterModem occasionally loses an AT+SQNSRECV command entirely
    during a burst, with zero "Command time-out" warning even after its own
    180s internal timeout elapses - meaning the library's own recovery path
    never even sees the stuck command. A *blocking* call has no way to
    survive that.
    Replaces the blocking modem.socketReceive() call in dra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
    [modem.cpp]
2026-08-09 Shrink async receive chunk size to narrow a parser-corruption window
    The async rework fixed the "lost command" hang, but live hardware then
    hit a different, more severe failure: a hard crash inside WalterModem's
    own _cmdProcessingTask (_finishModemCMD dereferencing a stale command
    pointer - identical crash signature and fault address to the very first
    crash fixed weeks ago), independent of blocking vs. async request style.
    The AT log pinpointed the trigger: "No free buffers" errors appeared
    *interrupting the hex dump* of a 1500-byte SQNSRECV response while it
    was still being received - fresh +SQNSRING notifications were arriving
    mid-transfer and corrupting the parser's buffer bookkeeping. A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
    [modem.cpp]
2026-08-09 Make socket send async too - crash consistently coincided with GGA resend
    Shrinking the receive chunk size (previous commit) didn't stop the
    crash - live hardware hit the identical _finishModemCMD fault
    (_cmdProcessingTask, EXCVADDR 0x548) again with 256-byte chunks. Went
    back through every log collected so far: in every single one, the crash
    or the surrounding "No free buffers"/stray-response symptoms began
    within a few hundred ms of the periodic GGA resend (ntripSendGGA(),
    every ~10s) - the same cadence the caster's periodic station-metadata
    burst arrives on.
    modemSocketSend() was still the *blocking* form - the receive path went
    async two commits ago, but the send path didn't. That means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
    [modem.cpp]
2026-08-09 Stop dropping RTCM on a failed read, and break GGA/burst phase-lock
    Crash fix confirmed working, but live hardware still forwarded only
    ~5.6KB of RTCM over a 120s fix cycle (far too little for continuous
    corrections, fix stayed autonomous) and 100% of GGA sends failed.
    Two separate bugs behind that:
    - onSocketReceiveComplete() silently dropped a chunk whenever its
    AT+SQNSRECV attempt got hit with a stray error during a burst (no
    longer a crash since the previous commit, but still data loss) - the
    modem hadn't necessarily discarded the data just because that specific
    read attempt failed. Now re-sets socketRingPending on error so
    drainSocketRing() retries instead of giving up on th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
    [main.cpp, modem.cpp]
2026-08-09 Patch a second unguarded cmd dereference in WalterModem (+SQNSRECV: )
    Live hardware crashed again at the same fault address (EXCVADDR 0x548)
    after ~70s of otherwise-healthy operation (the previous commit's retry
    and GGA-cadence fixes were visibly working - many successful 256-byte
    RTCM chunks flowing throughout the saved log), but via a different path:
    _processModemRSP()'s "+SQNSRECV: " branch dereferences cmd->rsp
    unconditionally, with no null check - unlike most other branches in the
    same function (e.g. the SIM card IMSI branch a bit further down, which
    explicitly checks cmd == NULL first). A stray/late "+SQNSRECV: "
    response with no command actually outstanding hits this exact gap.
    Same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
2026-08-09 Retry NTRIP connect on failure instead of waiting for the next fix cycle
    Without this, a failed ntripConnect() (bad response, TCP dial failure,
    rejected auth) meant no RTCM for the entire rest of that fix cycle - the
    next attempt only came on the next measurement_interval_s wake, which
    defaults to 10 minutes. Per user report, a 401 Unauthorized from this
    caster is often transient and clears on a quick retry.
    ntripConnect() now retries internally, up to 3 attempts: 5s before
    retrying after a 401 specifically (observed to usually be transient, not
    a real credentials problem), 10s for any other failure (no response,
    rejected request, TCP dial failure). Split the original body into
    ntripConnect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
    [ntrip_client.cpp, ntrip_client.h]
2026-08-09 Defer GGA send while a receive is in flight instead of guessing timing
    The GGA/burst phase-lock fix (7s resend interval, to avoid a round-10s
    collision with this caster's periodic burst) helped but didn't fully
    solve it - live hardware still showed 100% of GGA sends failing with
    "+CME ERROR: 4" even at the offset interval, because the receive-retry
    fix increased how often a receive is genuinely in flight at any given
    moment (good for RTCM throughput - one log went from ~5.6KB to ~60KB
    forwarded per fix cycle - but it means timing-based avoidance alone
    isn't reliable).
    Added modemReceiveBusy() (modem.cpp) exposing whether an async receive
    is currently outstanding. ntripSendGGA() now checks i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
    [main.cpp, modem.cpp, modem.h]
2026-08-09 Retry GGA sends quickly on async failure - this NTRIP mount needs GGA
    Confirmed with the user: SVALBARD is network RTK/VRS, which genuinely
    requires periodic GGA to know where to center corrections (unlike a
    single physical base station, which would send the same stream
    regardless of rover position) - so unreliable GGA delivery plausibly
    explains the fix quality staying autonomous despite 60KB+/cycle of RTCM
    now flowing.
    The modemReceiveBusy() defer (previous commit) helped - live hardware
    showed some GGA sends actually succeeding now, where 100% failed
    before - but not enough: modemSocketSend() only reports whether the
    command was successfully *queued*, not whether it actually succeeded.
    A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
    [main.cpp, modem.cpp, modem.h]
2026-08-09 Give GGA sends a guaranteed-clear window instead of just checking busy
    modemReceiveBusy() (previous commit) helped but wasn't enough on its
    own: live hardware measured only ~29% of GGA sends actually succeeding.
    RTCM now drains almost continuously (every RING immediately re-triggers
    another receive), so the "not busy right now" window that check looks
    for is often only a few ms wide - a fresh receive can get kicked off in
    the gap between checking and actually sending.
    Added modemSuppressReceiveFor(ms): holds off any *new* async receive
    kickoff for a short window, called right before a GGA send so it gets
    one guaranteed-clear shot at the AT channel. A receive already in
    flight when suppressi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
    [modem.cpp, modem.h, ntrip_client.cpp]
2026-08-09 Widen NTRIP 401 retry budget - a flat 3x5s wasn't enough
    Live hardware hit 401 Unauthorized on all 3 retry attempts in a row
    (15s total). User confirmed independently: restarting the device and
    waiting clears it, consistent with caster-side session state (e.g. a
    previous connection not yet timed out server-side) needing real
    wall-clock time, not a fixed short retry.
    MAX_ATTEMPTS 3 -> 5, and the 401-specific delay now increases each
    attempt (5s, 15s, 30s, 45s) instead of a flat 5s - worst case ~95s of
    retrying before giving up, still bounded well within a single fix
    cycle. Non-401 failures keep their existing fixed 10s delay - no
    evidence they need the same treatment.
    [ntrip_client.cpp]
2026-08-09 Rewrite README for the Walter/cellular field-deployment architecture
    Replaces the old WiFi + ESP32 DevKit V1 description (config portal,
    deep-sleep cycle, SD logging "pending hardware") with the current
    Walter ESP32-S3 + cellular design: persistent loop() for continuous
    geophone capture, field-service menu over USB CDC, geophone/MiniSEED,
    SD_MMC storage, batched MQTT, daily chunked upload, the task watchdog,
    and the vendored WalterModem patch. Documents the still-open SD card
    0x107 mount issue as a known hardware item, not a firmware TODO.
2026-08-09 Add F9P RTCM diagnostic, and enable RTCM3 as a UART1 input protocol
    RTCM throughput reached 90KB+/cycle and GGA started reaching the
    caster, but the fix stayed autonomous regardless - suspected the
    F9P itself might not be doing anything useful with what we forward it,
    rather than a delivery problem. Added ground truth instead of guessing
    further: enabled UBX-RXM-RTCM (class 0x02 id 0x32) on UART1, which the
    F9P emits for every RTCM message it processes, reporting the message
    type and whether it passed CRC. Parses it with a small hand-rolled UBX
    binary frame reader (gnss.cpp's NMEA handling doesn't touch binary UBX
    at all) and prints "[RTCM-IN] type=... station=... ok/CRC-FAIL".
    That diagnos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
    [gnss.cpp, gnss.h, main.cpp]
2026-08-09 Fix heap corruption from repeated String allocation in ntripSendGGA()
    Live hardware crashed with "CORRUPT HEAP: Bad tail" (ESP32's heap
    poisoning check), detected inside an unrelated String's destructor a
    few calls later - classic heap fragmentation from Arduino's String
    class, not a WalterModem issue this time. ntripSendGGA() allocated a
    new String on every call that got far enough to actually send, and
    between the priority-window and fast-retry-on-failure logic added
    recently, that now happens often enough over a long-running test to
    fragment the heap badly.
    Replaced with a fixed 102-byte stack buffer + snprintf (gnssLastGGA()'s
    source buffer is 100 bytes; +2 for "\r\n" +1 for NUL) - no a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
    [ntrip_client.cpp]
2026-08-10 Fix GGA/HTTP-request corruption from modemSocketSend() use-after-free
    WalterModem::socketSend() (WalterSocket.cpp) queues AT+SQNSSENDEXT and
    stores the caller's raw pointer as cmd->payload without copying it -
    the actual UART write only happens later, asynchronously, when the
    "> " data prompt is parsed. Callers passing a stack-local buffer
    (ntripSendGGA()'s line) or a temporary String's internal buffer
    (ntripConnectOnce()'s request) had that memory reused by other code
    before the async write actually happened.
    Confirmed on live hardware: the bytes actually transmitted for a GGA
    send were garbage ("$G" followed by unrelated float/double data), not
    the NMEA sentence built moments earlier - ex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
    [modem.cpp, modem.h]
2026-08-10 Fix GNSS UART starvation during RTCM forwarding bursts
    ntripPoll() drained the whole modem receive ring before ever calling
    pollGNSS() again. GPS_BAUD is only 38400, so forwarding even a modest
    RTCM chunk to the F9P can take long enough that gnssWriteRTCM()
    blocks waiting for TX space - during that stretch nothing drains what
    the F9P is sending back (NMEA, UBX ACKs, RXM-RTCM), so its replies sit
    in ESP32's own UART RX ring until it silently overflows.
    Shrunk the forwarding chunk size and interleave pollGNSS() after each
    one instead of draining the whole burst first - keeps the gap between
    GNSS UART services small regardless of how much RTCM is queued.
    [ntrip_client.cpp]
2026-08-10 Wait for an initial GNSS fix before opening NTRIP, per CPOS docs
    CPOS (Kartverket's network RTK service behind this NTRIP mount)
    documents that a client must already have a regular fix - autonomous
    is fine - before opening an NTRIP session: the correction stream is
    centered on whatever position the first GGA carries, so connecting
    earlier just spends the window sending a quality=0/empty GGA the
    caster has nothing to center corrections on. The modem has nothing
    else to do during that wait, so deferring the connect costs nothing.
    Also switched the GGA resend interval to CPOS's documented 10s. The
    previous non-round 7s value was working around GGA sends failing near
    a caster metadata burst, bu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
    [main.cpp]
2026-08-10 Fix GPS/modem UART peripheral conflict
    gnss.cpp declared GPSSerial on hardware UART peripheral 2
    (HardwareSerial GPSSerial(2)), but the Arduino core's global Serial2
    object - used by modem.cpp for the Sequans modem (modem.begin(&Serial2))
    - is ALSO peripheral 2 (HardwareSerial Serial2(2), core/HardwareSerial.cpp).
    Two HardwareSerial C++ instances bound to the same uart_nr share the
    same underlying IDF UART driver, ring buffer, and GPIO matrix routing,
    not just the same "logical" port.
    modemInit() (Serial2.begin(), pins 14/48) runs after initGNSS() (this
    begin(), pins 16/17) in setup(). IDF's uart begin() detaches whichever
    pins were previously attached and re-routes the peripheral to the ne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
    [gnss.cpp]
2026-08-10 Add UBX-ACK/NAK diagnostic for F9P config commands
    The F9P sends UBX-ACK-ACK/UBX-ACK-NAK for every UBX-CFG-* message it
    receives, unconditionally, regardless of what that message configures.
    Logs these so it's possible to tell whether our CFG-MSG/CFG-VALSET
    commands (GST enable, RXM-RTCM enable, RTCM3X-input enable) are
    actually being received/accepted at all, versus UBX output simply
    being off for this port and every one of these frames going unseen.
2026-08-10 Reduce debug log verbosity to prevent watchdog resets under load
    Live hardware crashed (task watchdog firing) once RTCM started
    flowing at real volume: the byte-by-byte raw NMEA mirror
    (DEBUG_PRINT_RAW_GNSS) and WalterModem's own AT command trace
    (ESP_LOGD, hex-dumping every RTCM chunk) together saturated the
    USB-CDC link, blocking the main task in Serial writes long enough to
    starve other tasks. This isn't just a monitoring-session problem -
    the same verbosity would cause the same resets during real field
    operation under sustained correction load, so quieting it is the
    correct permanent default, not a debugging-only workaround. Both
    flags/levels can still be raised back for short, targeted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
    [gnss.cpp, main.cpp]
2026-08-10 Document tried-and-reverted Sequans transparent-mode exploration
    AT+SQNSD's connMode=0 (the chip's own default, though every socket
    method in WalterModem hardcodes connMode=1/command mode) turns the
    UART into a raw pipe straight to the socket after CONNECT - looked
    like a clean way to avoid command mode's crash/timing bugs, and a
    small library patch was added to support it (stop the library's own
    RX handler from parsing raw RTCM bytes as AT responses).
    Live hardware testing showed the caster never receiving anything at
    all once dialed this way, across every variation tried: matching
    socketDial()'s own +SQNSD parameter list exactly (including an
    undocumented trailing field), disabling hardwa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
2026-08-10 Quiet RTCM-IN/UBX-ACK diagnostics to errors-only
    Confirmed on live hardware that RTCM validates "ok" here once real
    corrections are flowing - only the failure case is still worth
    surfacing. Printing every message (several per second under real
    RTCM load) was itself a Serial-blocking risk stacked on top of the
    others already fixed - same class of task-watchdog exposure, just
    smaller. Kept the failure paths (CRC-FAIL, NAK) since those are what
    would actually need investigating.
    [gnss.cpp]
2026-08-10 Add periodic mid-cycle RTK status print
    Live hardware has been hitting a task-watchdog reset partway into
    sustained RTCM traffic before every cycle's end-of-cycle summary can
    print - root cause not yet found (the async modem command paths that
    could plausibly explain a hang were traced through the vendored
    library source and all fail gracefully rather than blocking). The F9P
    is a separate chip that very likely keeps its own RTK engine state
    across an ESP32 reboot - only the correction stream itself actually
    stops, briefly, during the ~10-20s reboot/reinit - so RTK convergence
    may still be progressing despite the instability. This print is what
    lets that be observed directly instead of only e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
    [main.cpp]
2026-08-10 Add diagnostics for previously-silent abandon/pool-full paths
    drainSocketRing() abandoning a stuck async receive, and
    socketReceive() failing to even queue (pool or internal command
    queue full), were both silent. Logging them to check whether either
    clusters right before the still-unexplained task-watchdog resets
    under heavy RTCM traffic - would be evidence of commands getting lost
    at an increasing rate under sustained load, rather than a one-off.
    Live testing so far shows neither firing before a crash, which rules
    out this specific mechanism as the cause.
    [modem.cpp]
2026-08-10 Fix task-watchdog resets under heavy RTCM load
    CORE_DEBUG_LEVEL=4 was a compile-time gate that kept WalterModem's
    per-chunk AT hex-dump trace in the binary regardless of the runtime
    esp_log_level_set("WalterModem", ESP_LOG_WARN) call already meant to
    silence it - confirmed on live hardware that the trace still printed
    in full, saturating the USB-CDC link and starving loopTask long enough
    to trip the watchdog mid-cycle. Lowering it to 2 actually compiles the
    ESP_LOGD calls out.
    Also make modemSocketClose() async like socketReceive/socketSend
    already are: it could land a blocking AT+SQNSH close right when the
    command channel was already under contention (the log showed "abandoning
    a stuck asy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
    [modem.cpp]
2026-08-10 Fix SD reliability, add PPK recording floor, restructure data layout for PPK
    SD card mount/writes:
    - SD_MMC.begin() defaulted to SDMMC_FREQ_HIGHSPEED (40MHz) - too aggressive
    for this carrier board's still-provisional SD wiring. Mount failed
    outright at 40MHz; at 20MHz it mounted but the first real write hit
    CRC/timeout bus errors. 10MHz has run clean since.
    - dailyFile (MiniSEED) and the old raw log file were held open all day and
    only ever flushed on close/date-rollover, so every reset (including our
    own repeated reflashing) silently discarded whatever was buffered -
    confirmed on live hardware as files reading back 0 bytes despite write()
    having been called repeatedly. Fixed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
    [device_config.cpp, device_config.h, field_service.cpp, gnss.cpp, gnss.h, main.cpp, miniseed_writer.cpp, position_log.cpp]
2026-08-10 Move all SD writes off loopTask onto a dedicated writer task
    Live hardware hit a task-watchdog abort with the exact same shape as the
    modem crashes fixed earlier - a blocking call landing on loopTask with no
    timeout - but from SD_MMC.write() this time: a burst of "sdmmc_send_cmd
    returned 0x107" (ESP_ERR_TIMEOUT) errors under heavy GNSS burst traffic,
    then total silence for ~60s before the abort. Arduino's SD_MMC File API
    has no async mode of its own, so unlike the modem's AT commands this
    can't be fixed by passing a callback - the blocking call itself has to
    move off the watchdog-registered task.
    Added a small fixed set of named streams (UBX, RTCM, MiniSEED, positions)
    backed by one dedicat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
    [gnss.cpp, gnss.h, main.cpp, miniseed_writer.cpp, ntrip_client.cpp, position_log.cpp, sd_storage.cpp, sd_storage.h]
2026-08-11 Calibrate external battery voltage divider
    Real measured ratio (x6.4545454545454) for BATTERY_EXTERNAL_ADC_PIN,
    replacing the placeholder 2.0 assumption - internal divider stays
    uncalibrated until its resistor values are known.
2026-08-11 Add MQTT telemetry publishing (battery, position, reference displacement)
    Publishes a batched JSON array of position_log rows (CSV rows already
    carry battery voltage and reference displacement) to the configured
    broker once per GNSS fix cycle, piggybacking on the modem session
    already open for NTRIP that cycle instead of a separate hourly wake.
    Two real bugs found and fixed against live hardware along the way:
    - AT+SQNSMQTTCFG referencing a TLS profile always failed with a plain
    ERROR (no CME code). Root cause: the CA cert was written to modem
    NVRAM slot 0, which is reserved for Sequans/BlueCherry-internal use
    (documented in tlsWriteCredential()'s own doc comment, and confirmed
    agai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
    [modem.cpp, modem.h, mqtt_client.cpp, mqtt_client.h]
2026-08-11 Add reference-position commissioning, low-battery backoff, and SD write safety
    Reference position / displacement (reference_position.h/cpp, new):
    - Field-service "commissioning" run averages GNSS fixes over a
    configurable window (default 2h) via Welford incremental mean,
    persisted across reboots so progress survives this project's
    frequent test resets. Locks a permanent reference position once the
    window elapses.
    - Once locked, every fix cycle computes WGS84 local-tangent-plane
    (north/east/up) displacement from that reference, logged to the
    position CSV and included in the MQTT payload.
    Low-battery backoff (device_config, main.cpp):
    - New low_battery_cutoff_v (field-service conf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
    [device_config.cpp, device_config.h, field_service.cpp, main.cpp, position_log.cpp, position_log.h, reference_position.cpp, reference_position.h]
2026-08-11 Flush and close SD streams cleanly before every self-triggered reboot
    sdStorageCloseAllForReboot() closes every stream and blocks (bounded)
    until the writer task confirms it, called right before each of the
    four ESP.restart() call sites this firmware controls (commissioning
    confirm, field-service exit, service-cable entry, card-detect
    remount). A reset the firmware itself decides to take is exactly the
    kind of corruption exposure worth closing off - unlike a genuine power
    loss, there's no reason to leave files open across it.
    [field_service.cpp, sd_storage.cpp, sd_storage.h]
2026-08-11 Fix MQTT publish reliability: two more real bugs found on live hardware
    Config/connect were already fixed (previous commit's CA-slot move), but
    publish itself kept failing intermittently with the same "plain ERROR,
    no CME code" shape as every other bug tonight. Two separate root causes:
    1. The whole config->connect->publish->disconnect chain was originally
    built via WalterModem's own async callback mechanism, each step
    calling the next from inside the previous step's callback. Every
    WalterModem callback runs on the library's own queueProcessing task,
    and chaining four AT commands that way stacked all four calls'
    frames on top of each other there - crashed live hardware with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
    [modem.cpp]
2026-08-11 Fix ThingsBoard telemetry timestamps: use {"ts":...,"values":{...}}
    ThingsBoard's MQTT telemetry API only honors a message's actual reading
    time if it's shaped {"ts":<epoch ms>,"values":{...}} - a flat object
    gets stamped with the server's ingestion time instead. Our payload was
    flat, so any batch published later than it was recorded (routine here:
    telemetry piggybacks on the next fix cycle's modem session, and can lag
    further behind a delayed backlog after one of this station's SD-card
    reboots) would show up in ThingsBoard timestamped at publish time, not
    the actual GNSS reading time.
    gnssEpochMillis() computes Unix epoch milliseconds directly from the
    UTC y/m/d/h/m/s TinyGPS++ already exp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
    [gnss.cpp, gnss.h, position_log.cpp]
2026-08-11 Add physical SD eject button
    GPIO 41 (INPUT_PULLUP, active LOW), continuing the same carrier-board
    pin grouping as SD_D3/SD_CARD_DETECT/FIELD_MODE_SELECT (38-40). A
    press flushes and closes every stream, unmounts SD_MMC, and cuts power
    to the card's rail (SD_POWER_EN_PIN) - closing file handles alone
    isn't enough, since the SD bus lines can still be electrically live
    mid-transaction even with nothing open. A second press while ejected
    (or just physically pulling and reinserting a card) reboots to remount
    cleanly, reusing sdCheckCardPresence()'s existing remount path rather
    than duplicating it.
    [main.cpp, pins.h, sd_storage.cpp, sd_storage.h]
2026-08-11 Fix GNSS backup-mode sleep never actually engaging
    gnssSleep() fires a UBX-RXM-PMREQ command but nothing ever confirmed
    the F9P actually entered backup mode. It didn't: instrumented with a
    byte counter (gnssCharsProcessed(), sampled every 2s rather than as a
    single cumulative total - a one-shot total can't tell "draining the
    ~1KB UART RX buffer already queued at sleep time" apart from "still
    receiving fresh bytes throughout", both look identical as one number)
    and confirmed on live hardware that the module kept transmitting
    continuously through the supposed sleep window.
    Root cause: wakeupSources was configured for both EXTINT0 and UART RX
    activity, the latter added as "a bring-up safety ne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
    [gnss.cpp]
2026-08-11 Add modem sleep between measurement cycles, fix misleading field name
    Modem sleep (modem.h/cpp, main.cpp):
    Between measurement cycles the modem has nothing to do - no
    subscriptions, no expected downlink, just telemetry it initiates
    itself - so there's no reason to stay registered on the LTE-M network
    for the ~80% of each measurement_interval_s cycle that isn't spent on
    an active NTRIP/MQTT burst. modemSleep() (setOpState(NO_RF)) mirrors
    gnss.cpp's gnssSleep()/gnssWakeup() pattern; modemConnect() brings it
    back by re-entering FULL opstate before waiting for registration,
    transparent to every existing caller.
    Deferred rather than called directly at the end of the fix cycle:
    telemetry publish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
    [main.cpp, modem.cpp, modem.h, position_log.cpp]
2026-08-12 Make eject button and field-service trigger responsive mid-burst
    checkFieldModeTrigger()/sdCheckEjectButton()/sdCheckCardPresence() were
    only polled once per outer loop() iteration - but a GNSS/NTRIP burst
    runs 100+s inside runGnssFixCycle()'s own internal polling loops
    (waitForInitialFix() and the main fix-wait loop), which never return
    control to the outer loop() until the whole cycle finishes. Pressing
    the eject button or grounding the field-service cable mid-burst went
    completely unnoticed until the cycle ended - confirmed on live
    hardware. Polled from inside both burst loops too, so a technician's
    input is picked up immediately regardless of what the cycle is doing.
    [main.cpp]
2026-08-12 Migrate SD storage from native SDMMC to SPI mode
    Native SDMMC (1-bit, even at a reduced 10MHz) kept hitting
    sdmmc_send_cmd 0x107 timeouts on this board's provisional SD wiring -
    about 14 in one overnight session. SPI's timing/signal-integrity
    requirements are looser and tolerates the marginal wiring much better,
    at a throughput cost this station never gets close to (single-digit
    KB/s sustained: continuous 400Hz geophone MiniSEED plus RTCM/UBX only
    during each GNSS burst). Same physical pins - an SD card's DAT3/CMD/
    CLK/DAT0 lines double as SPI's CS/MOSI/SCLK/MISO, only the host init
    sequence decides the protocol. Confirmed on live hardware: mount
    succeeds and UBX/RTCM/MiniSEED/positions stre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
    [field_service.cpp, main.cpp, pins.h, sd_storage.cpp, sd_storage.h, upload_client.cpp]
2026-08-12 Fix geophone MiniSEED timestamps freezing during GNSS idle
    TinyGPS++'s year/month/day/hour/minute/second fields (and
    gnssEpochMillis(), built from them) never expire on their own -
    isValid() is a sticky flag, not an age check - so they keep reporting
    whatever the wall clock was at the F9P's *last* fix indefinitely,
    including all through backup-mode sleep between measurement cycles.
    miniseed_writer.cpp used these directly to stamp each record's start
    time, so every record created during an idle window got the exact
    same frozen timestamp and collided in the output file.
    This was a direct, unintended side effect of tonight's GNSS-sleep fix
    actually working: previously the F9P never really slep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
    [gnss.cpp, gnss.h, miniseed_writer.cpp]
2026-08-12 Retry position-log SD rotation after a failed open
    rotateIfNeeded() committed currentDate to the new day before knowing
    whether the async sdStreamOpen() actually succeeded. A single failed
    open right at rotation - seen on live hardware, racing the tail end
    of a GNSS burst's own SD writes - left position/displacement logging
    silently stuck for the rest of the day: every later call saw
    today == currentDate and never tried the open again.
    Now checks sdStreamIsOpen() on every call once "already rotated" and
    retries the open if it never actually landed. Cheap to check every
    call (positionLogAppend() only runs once per measurement cycle) and a
    no-op once the file is genuinely open.
    Also renames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
    [position_log.cpp]
2026-08-15 Expose SD card as USB mass storage during field service mode
    Field service's old file access was a custom serial protocol (list +
    BEGIN/raw-bytes/END download) tunneled over the same console
    connection - slow, and needed a client that spoke the protocol.
    Switches ARDUINO_USB_MODE from 1 (fixed-function USB-Serial/JTOP) to
    0 (native USB OTG/TinyUSB), which allows a composite CDC+MSC
    descriptor: the console keeps working exactly as before, and the SD
    card now also shows up as an ordinary drive on the same USB
    connection.
    The MSC LUN is registered unconditionally in setup() via
    sdStorageMscBegin(), since USB interfaces can't be added after
    enumeration - but it reports "no media" until sdStorag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
    [field_service.cpp, main.cpp, sd_storage.cpp, sd_storage.h]
2026-08-15 Add GETTING_STARTED guide, sync README with recent hardware/firmware changes
    README hadn't been touched since the original Walter/cellular rewrite,
    so it had drifted well behind several already-merged changes: SD moved
    from native SDMMC to SPI, the physical eject button, GNSS/modem sleep
    and low-battery backoff, reference-position commissioning, MQTT
    telemetry (including the ThingsBoard ts/values payload shape and
    displacement fields), and now USB mass-storage field-service access.
    Rewrites the pin table, file map, power-management, field-service, fix
    cycle, telemetry, and MQTT payload sections to match current behavior,
    and drops the two Known Issues entries that no longer apply (SD mount
    f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
